Even-lwx/ADS124S08_RTD_Acq/code/code/README.md

# ADS124S08 四路 PT1000 采集与温控库

## 硬件映射

| 功能 | STM32G031 | PCB 网络/器件 | 有效电平 |
| --- | --- | --- | --- |
| SPI SCLK | PA1 | ADS124S08 SCLK | SPI Mode 1 |
| SPI MISO | PA6 | ADS124S08 DOUT/DRDY# | 低表示数据就绪 |
| SPI MOSI | PA7 | ADS124S08 DIN | — |
| SPI CS | PA5 | ADS124S08 CS# | 低有效 |
| Debug TX/RX | PA2/PA3，USART2 | H1-1/H1-2，115200 8N1 | — |
| 业务 TX/RX | PA9/PA10，USART1 | H3 跳线选择 RS485/TTL，9600 8N1 | — |
| RS485 方向 | PC6 | SN65HVD75 DE 与 RE# | 高发送、低接收 |
| PID PWM | PD1，TIM17_CH1 | PCB 的 EN 网络，1 kHz | 高有效 |
| 按键 SW2 | PB3 | BUTTON，R19/R20/SW2 | 按下为低 |
| 黄色 LED1 | PA12 | LED1、R21 | 低电平点亮 |
| 黄色 LED3 | PA15 | LED3、R27 | 低电平点亮 |

H3 短接 1-3、2-4 时 USART1 连接 RS485；短接 3-5、4-6 时连接 H4 TTL。

按键与 LED 极性来自最新原理图
`ADS124S08‑RTD‑Acq-Ver1.0/Sheet1.SchDoc`：BUTTON 节点由 R19（4.7 kΩ）上拉，
按下 SW2 后接地；LED1/LED3 的阳极分别经 1 kΩ 电阻接 3V3，阴极由 MCU 灌电流。

## 自有库目录

- `ads124s08/`：SPI 命令、寄存器配置、ID 校验和单次转换。
- `pt1000/`：比例码值转电阻、通道标定和 IEC 60751 温度换算。
- `pid/`：带积分限幅和输出限幅的离散 PID。
- `app/`：四通道周期采集、串口组帧和仅加热温控。
- `board_io/`：板载 LED 与带 20 ms 非阻塞消抖的按键驱动。
- `rs485/`：USART1 中断收发、PC6 方向切换和帧间隔检测。
- `modbus_rtu/`：支持03读取和06单写的Modbus RTU从机协议层。

## RS485 与 Modbus RTU

USART1 固定配置为 `9600 8N1`，Modbus RTU从机地址固定为 `1`。H3 短接
1-3、2-4 时，PA9/PA10 通过 SN65HVD75 接入 RS485 总线；短接 3-5、4-6
时，同一套Modbus协议以TTL电平从H4输出。PC6同时连接DE和/RE，
发送期间为高电平，最后一个停止位发送完成后立即恢复低电平接收状态。

接收采用USART1单字节中断，连续静默至少4 ms后把完整帧交给协议层。
CRC16初值为 `0xFFFF`、多项式为 `0xA001`，帧内CRC低字节先发送。
支持 `0x03` 读取保持寄存器和 `0x06` 写单个保持寄存器。CRC错误、帧长
错误、其他从机地址以及地址0广播均静默丢弃；非法功能、地址和值分别返回
异常码 `01/02/03`。485写入只保存在RAM，重新上电后恢复固件默认值。

| 地址 | 名称 | 属性 | 编码 |
| --- | --- | --- | --- |
| 0x0000 | 系统状态 | 只读 | bit0使能、bit1加热、bit2反馈有效、bit3过温锁定、bit4 ADC就绪、bit8~11为CH1~CH4有效 |
| 0x0001 | CH1温度 | 只读 | 有符号16位，0.01 ℃；无效为0x8000 |
| 0x0002 | CH2温度 | 只读 | 有符号16位，0.01 ℃；无效为0x8000 |
| 0x0003 | CH3温度 | 只读 | 有符号16位，0.01 ℃；无效为0x8000 |
| 0x0004 | CH4温度 | 只读 | 有符号16位，0.01 ℃；无效为0x8000 |
| 0x0005 | PID最高温度反馈 | 只读 | 有符号16位，0.01 ℃；无效为0x8000 |
| 0x0006 | PWM占空比 | 只读 | 0.01%，例如2400表示24.00% |
| 0x0007 | 目标温度 | 读写 | 0.01 ℃，允许0至严格低于45 ℃ |
| 0x0008 | 加热使能 | 读写 | 0=立即停热，1=下一轮有效采样后恢复 |

写入目标温度或使能状态时，控制器先把PWM归零并清除旧目标的PID历史，
再从下一轮有效温度重新建立平滑参考。过温锁定不能通过485清除，仍然
只能重新上电；全部传感器无效时，485也不能绕过安全停机。

四路ADS124S08采集目前仍是阻塞式操作。USART1中断可以在采样期间完整收帧，
但协议响应要等主循环返回，主机响应超时应设置为至少500 ms。USART2继续
独立输出FireWater数据，不发送任何Modbus内容。Modbus是二进制协议，应使用
Modbus主站软件测试；普通串口文本窗口不会按一行文本显示RTU帧。

## 按键与 LED 接口

`MX_GPIO_Init()` 后调用 `BoardIO_Init()`，并在主循环中持续调用
`BoardButton_Update()`。应用层可使用：

```c
BoardLED_Set(BOARD_LED_1, 1U);       /* 点亮 LED1 */
BoardLED_Toggle(BOARD_LED_3);        /* 翻转 LED3 */

if (BoardButton_GetPressedEvent())   /* 每次稳定按下只返回一次 */
{
  BoardLED_Toggle(BOARD_LED_1);
}
```

`BoardButton_IsPressed()` 返回当前消抖状态；`BoardButton_GetPressedEvent()` 和
`BoardButton_GetReleasedEvent()` 分别读取并清除按下/释放事件。驱动已封装低有效极性。

主循环还会调用 `BoardHeatingIndicator_Update()` 驱动 PA12/LED1：TIM17 实际
占空比大于 0 时，每 100 ms 翻转一次（完整周期 200 ms）；占空比为 0 时，
每 500 ms 翻转一次（完整周期 1 s）。闪烁使用 `HAL_GetTick()` 非阻塞计时，
不会影响温度采集和 PID 更新。

## 独立看门狗

固件在全部外设、采集应用和 PWM 输出初始化完成后启动 IWDG。看门狗使用独立
LSI 时钟、256 分频、重装值 499；按典型 32 kHz LSI 计算，超时时间约为 4 秒。
主循环只有在按键、四路采集、温控和 LED 指示任务全部返回后才喂狗。如果程序
卡死或任务长期不能返回，IWDG 将自动复位 MCU，并由上电安全逻辑先保持加热关闭。

## ADS124S08 配置

| 寄存器 | 值 | 含义 |
| --- | --- | --- |
| PGA (03h) | 08h | PGA 开启，增益 1 |
| DATARATE (04h) | 35h | 单次转换、低延迟滤波、50 SPS |
| REF (05h) | 52h | REFP0/REFN0，内部参考常开供 IDAC，并开启 0.3 V 参考监测 |
| IDACMAG (06h) | 04h | IDAC1/2 幅值 250 µA |
| SYS (09h) | 10h | 无 CRC、无状态前缀 |

通道顺序固定为：

1. IDAC1→AIN11，AIN0-AIN1。
2. IDAC1→AIN10，AIN2-AIN3。
3. IDAC1→AIN9，AIN4-AIN5。
4. IDAC1→AIN8，AIN6-AIN7。

IDAC2 始终断开；SPI 使用 Mode 1、8 MHz。每路单次转换的典型首次结果延迟
约为 26.504 ms，固件保守等待 35 ms；四路每 200 ms 采集一轮，即 5 Hz。

## 标定与串口输出

默认参考电阻为 3000.0 Ω，PT1000 标称电阻为 1000.0 Ω。调用
`PT1000_AppGetDefaultConfig()` 后，可修改参考电阻实测值以及各通道的
`resistance_gain`、`resistance_offset_ohm`。

USART2 在工作模式下每轮输出一行固定 20 列的纯数字 FireWater 数据，
当前输出频率与四路采集和 PID 更新频率一致，均为 5 Hz：

```text
25.01,25.03,24.99,25.02,42.00,25.09,25.03,0.06,0.01,2.000,0.025,4.000,0.12,8.36,0.04,8.52,24.00,0.20,4,1\n
```

列顺序固定为：

```text
T1,T2,T3,T4,SP,REF,FB,ERR,RATE,KP,KI,KD,P,I,D,OUT,LIM,DT,VALID,STATE
```

`SP` 是最终目标温度，`REF` 是从当前反馈平滑接近目标的内部参考温度，
`FB` 是参与控制的合成反馈，`ERR=REF-FB`，`RATE` 是低通滤波后的实际温变速率，
`P/I/D` 是三个实际输出分量，`OUT` 是限幅后的高有效 PWM 占空比，
`LIM` 是当前允许的占空比上限，`DT` 是本次计算间隔，`VALID` 是有效传感器数。
`KP/KI/KD` 固定显示三位小数，其余浮点列显示两位小数，因此 `Ki=0.025`
会原样输出，不再四舍五入显示为 `0.03`。
`STATE=1` 表示正在控制，`STATE=0` 表示传感器不足或控制被禁用，
`STATE=2` 表示任一有效通道达到 45 ℃ 后已锁定停机。状态 0 和 2 均强制
加热输出归零；过温锁定只能通过重新上电清除。失效温度列用 `0.00` 占位，
需结合 `VALID/STATE` 判断。ADC 原始码仍保存在内部快照中，但不输出到
FireWater，避免百万级码值把温度和 PID 曲线压缩在图表底部。

## PWM 与仅加热 PID

TIM17 使用 64 MHz 时钟、PSC=63、ARR=999，在 PD1/EN 输出 1 kHz 高有效 PWM。
每得到一轮新的四通道温度后更新一次 PID，当前反馈为所有有效通道中的最高温度。
至少一路传感器有效时允许控制；全部无效时，占空比立即归零并清除积分项。

PID 参数入口位于 `Core/Src/main.c`：

```c
temperature_control_config.setpoint_c = 42.0f;
temperature_control_config.pid.kp = 2.0f;
temperature_control_config.pid.ki = 0.025f;
temperature_control_config.pid.kd = 4.0f;
temperature_control_config.pid.derivative_filter_time_constant_s = 1.0f;
temperature_control_config.reference_time_constant_s = 12.0f;
temperature_control_config.reference_max_rate_c_per_s = 0.30f;
temperature_control_config.pid.integral_max = 12.0f;
temperature_control_config.feedback_mode = TEMPERATURE_FEEDBACK_MAXIMUM;
temperature_control_config.overtemperature_c = 45.0f;
```

控制器使用两自由度结构。内部参考 `REF` 从首次有效反馈开始，以 12 s 一阶时间常数
和最大 0.30 ℃/s 速度接近 42 ℃，因此初始温差不会直接产生很大的比例输出。
`Kp=2.0`、`Kd=4.0` 对参考跟踪误差和变化率进行修正，D 项使用 1 s 一阶低通，
避免 ADC 噪声被放大。积分项以电压曲线给出的维持功率作为前馈初值；只有最终
目标误差不超过 2 ℃且实际温变速率不超过 0.10 ℃/s 时，`Ki=0.025` 才在线
学习当前散热环境所需的维持功率。积分仍带 0～12% 限幅和条件抗饱和。
安全限幅只限制占空比；TPS27S100 导通时的输出高电平仍接近 VIN。
本板未把 VIN 接入 MCU ADC，因此固件无法在 12～24 V 变化时自动换算功率限幅。

控制误差为“内部参考温度 - 反馈温度”，最终目标始终保持 42 ℃。输出下限为 0%，所以框架只会
加热，不会产生制冷方向。PD1/EN 的 PWM 为高电平有效。反馈可选
平均值、最大值、最小值或指定通道，见 `TemperatureControl_FeedbackMode`。

### PWM 阶梯测试模式

`Core/Src/main.c` 中的 `PWM_RUN_MODE` 是唯一的模式选择宏。当前值为
`PWM_RUN_MODE_WORK`，固件使用四路温度反馈进行 PID 控制。需要验证硬件时，
可将该宏改为 `PWM_RUN_MODE_TEST`；固件将绕过 PID，让 PD1/EN 按
10 秒间隔循环输出 20%、40%、60%、80% 和 90% 高电平占空比。PWM 硬件
测试模式不执行 PID，因此不输出上述 FireWater 温控帧。

### 输入电压补偿

`Core/Src/main.c` 中的 `TEMPERATURE_INPUT_VOLTAGE_V` 是实际接入 VIN 的电压宏，
当前默认值为 `12.0f`。初始化温控器时，`temperature_control_profile.c` 会依据实测
日志只对维持功率前馈初值和安全输出上限进行分段线性插值：

| VIN | 9 V | 12 V | 15 V | 18 V | 24 V |
| --- | ---: | ---: | ---: | ---: | ---: |
| 积分初值前馈（%） | 10.78 | 8.36 | 7.43 | 7.27 | 7.10 |
| PWM 输出上限（%） | 30.0 | 24.0 | 24.0 | 24.0 | 18.0 |

9~18 V 的锚点来自 680 ohm 限流电阻下四份实测数据尾段的 `I` 积分项平均值，24 V 为设计上限
处的保守外推值。Kp、Ki、Kd、参考轨迹和速率滤波不按电压或绝对温度查表，
避免把某次环境下的升温曲线固化进控制器。电压表中的积分初值只是上电先验值，
实际维持功率由闭环在目标附近在线学习。学习值保存在 RAM，重新上电后从电压表
初值重新开始，避免频繁写 Flash。
改变电压时只需修改该宏并重新编译；函数会把超出 9~24 V 的值限制到最近端点。

## 硬件限制

最新版 `Sheet1.SchDoc` 中，ADS124S08 的 START/SYNC 通过 AGND 电源端口接地，
RESET# 通过 3V3 电源端口拉高，满足数据手册的软件命令控制要求。独立 DRDY#
未连接，固件按数据手册第 71 页使用 SPI MISO 上复用的 DOUT/DRDY 状态轮询。
