Even-lwx/ADS124S08_RTD_Acq/(list of files, drawings)

Other design files:
pcb/ADS124S08‑RTD‑Acq/ADS124S08‑RTD‑Acq-Ver1.0/ADS124S08‑RTD‑Acq.PrjPcb
pcb/ADS124S08‑RTD‑Acq/ADS124S08‑RTD‑Acq-Ver1.0/PCB1.PcbDoc
pcb/ADS124S08‑RTD‑Acq/ADS124S08‑RTD‑Acq-Ver1.0/Sheet1.SchDoc
pcb/ADS124S08‑RTD‑Acq/ADS124S08‑RTD‑Acq/PCB1.PcbDoc
pcb/ADS124S08‑RTD‑Acq/ADS124S08‑RTD‑Acq/Sheet1.SchDoc
