Even-lwx/ADS124S08_RTD_Acq/code/Core/Src/main.c

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
/* Includes ------------------------------------------------------------------*/
#include "main.h"
#include "spi.h"
#include "tim.h"
#include "usart.h"
#include "gpio.h"
#include "iwdg.h"

/* USER CODE BEGIN Includes */

#include "pt1000_app.h"
#include "temperature_control.h"
#include "temperature_control_profile.h"
#include "pwm_duty_test.h"
#include "board_io.h"
#include "temperature_modbus.h"

/* USER CODE END Includes */

/* USER CODE BEGIN PTD */

/** @brief PWM 输出运行模式。 */
typedef enum
{
  PWM_RUN_MODE_WORK = 0, /**< 正常工作：由四路温度反馈和 PID 调整占空比。 */
  PWM_RUN_MODE_TEST      /**< 测试模式：循环输出五档固定占空比。 */
} PWM_RunMode;

/* USER CODE END PTD */

/* USER CODE BEGIN PD */

/** 只需修改此宏即可在正常 PID 工作模式和 PWM 阶梯测试模式之间切换。 */
#define PWM_RUN_MODE PWM_RUN_MODE_WORK

/*
 * 第二轮整定加入小积分项。Kp 的单位为“占空比百分点/℃”：
 * 例如跟踪误差为 1 ℃、Kp=2 时，P 输出为 2%。
 * Ki 的单位为“占空比百分点/(℃·s)”，用于缓慢消除纯 P 稳态误差。
 */
#define TEMPERATURE_SETPOINT_C 42.0f
#define TEMPERATURE_INPUT_VOLTAGE_V 14.0f
#define TEMPERATURE_PID_KP      2.0f
#define TEMPERATURE_PID_KI      0.025f
#define TEMPERATURE_PID_KD      4.0f
/** 内部参考轨迹的一阶时间常数；越大则接近目标时减速越早。 */
#define TEMPERATURE_REFERENCE_TIME_CONSTANT_S 12.0f
/** 内部参考轨迹允许的最大升温/降温速度。 */
#define TEMPERATURE_REFERENCE_MAX_RATE_C_PER_S 0.30f
/** D 项低通滤波时间常数，用于抑制 ADC 噪声放大。 */
#define TEMPERATURE_D_FILTER_TIME_CONSTANT_S 1.0f
/** 工作模式下允许输出的最大高有效 PWM 占空比。 */
#define TEMPERATURE_PWM_MAX_DUTY_PERCENT 30.0f
/** 积分项单独限幅，避免积分独自给出过大的持续加热功率。 */
#define TEMPERATURE_PID_INTEGRAL_MAX_PERCENT 12.0f
/** 默认值；实际值由 TEMPERATURE_INPUT_VOLTAGE_V 的电压曲线函数覆盖。 */
#define TEMPERATURE_PID_INTEGRAL_INITIAL_PERCENT 5.5f
/** 任一有效通道到达此温度时锁定关闭加热，直到重新上电。 */
#define TEMPERATURE_OVERTEMPERATURE_C 45.0f
/** 非 0 时每轮输出一行纯数字 FireWater 温控数据，当前采集频率为 5 Hz。 */
#define TEMPERATURE_PID_TELEMETRY_ENABLE 1U
/** USART1/RS485 上固定使用的 Modbus RTU 从机地址。 */
#define TEMPERATURE_MODBUS_SLAVE_ADDRESS 1U

/* USER CODE END PD */


/* USER CODE BEGIN PV */

static PT1000_App pt1000_app;
static PT1000_AppConfig pt1000_config;
static PWM_DutyTest pwm_duty_test;
static TemperatureControl temperature_control;
static TemperatureControl_Config temperature_control_config;
static TemperatureModbus_HandleTypeDef temperature_modbus;

/* USER CODE END PV */

void SystemClock_Config(void);
/**
  * @brief  The application entry point.
  * @retval int
  */
int main(void)
{
  /* MCU Configuration--------------------------------------------------------*/

  /* Reset of all peripherals, Initializes the Flash interface and the Systick. */
  HAL_Init();

  /* Configure the system clock */
  SystemClock_Config();

  /* Initialize all configured peripherals */
  MX_GPIO_Init();
  /* USART2/H1 用于输出纯数字 FireWater 温控数据。 */
  MX_USART2_UART_Init();
  MX_SPI1_Init();
  MX_TIM17_Init();
  MX_USART1_UART_Init();
  /* USER CODE BEGIN 2 */

  BoardIO_Init();

  PT1000_AppGetDefaultConfig(&pt1000_config);
  PT1000_AppInit(&pt1000_app, &hspi1, &huart2,
                 ADS124S08_CS_GPIO_Port, ADS124S08_CS_Pin,
                 GPIOA, GPIO_PIN_6, &pt1000_config);

  if (PWM_RUN_MODE == PWM_RUN_MODE_TEST)
  {
    /* 测试模式绕过 PID，避免温度有效性检查把测试占空比重新置为 0%。 */
    if (PWM_DutyTest_Init(&pwm_duty_test, &htim17,
                          TIM_CHANNEL_1) != HAL_OK)
    {
      __HAL_TIM_SET_COMPARE(&htim17, TIM_CHANNEL_1, 0U);
    }
  }
  else
  {
    TemperatureControl_GetDefaultConfig(&temperature_control_config);
    /* 根据首轮纯 P 曲线加入小积分项，用于消除约 2.37 ℃ 稳态误差。 */
    temperature_control_config.setpoint_c = TEMPERATURE_SETPOINT_C;
    temperature_control_config.pid.kp = TEMPERATURE_PID_KP;
    temperature_control_config.pid.ki = TEMPERATURE_PID_KI;
    temperature_control_config.pid.kd = TEMPERATURE_PID_KD;
    temperature_control_config.pid.derivative_filter_time_constant_s =
        TEMPERATURE_D_FILTER_TIME_CONSTANT_S;
    temperature_control_config.pid.output_max =
        TEMPERATURE_PWM_MAX_DUTY_PERCENT;
    temperature_control_config.pid.integral_max =
        TEMPERATURE_PID_INTEGRAL_MAX_PERCENT;
    temperature_control_config.pid.integral_initial =
        TEMPERATURE_PID_INTEGRAL_INITIAL_PERCENT;
    /* 根据实际 VIN 只选择维持功率前馈初值和硬件安全输出上限。 */
    TemperatureControl_ApplyVoltageProfile(&temperature_control_config,
                                           TEMPERATURE_INPUT_VOLTAGE_V);
    temperature_control_config.reference_time_constant_s =
        TEMPERATURE_REFERENCE_TIME_CONSTANT_S;
    temperature_control_config.reference_max_rate_c_per_s =
        TEMPERATURE_REFERENCE_MAX_RATE_C_PER_S;
    temperature_control_config.feedback_mode =
        TEMPERATURE_FEEDBACK_MAXIMUM;
    temperature_control_config.overtemperature_c =
        TEMPERATURE_OVERTEMPERATURE_C;
    temperature_control_config.telemetry_enabled =
        TEMPERATURE_PID_TELEMETRY_ENABLE;
    if (TemperatureControl_Init(&temperature_control, &htim17, TIM_CHANNEL_1,
                                &pt1000_app,
                                &temperature_control_config) != HAL_OK)
    {
      /* PWM/PID 初始化失败时保持 PD1/EN 为安全的非加热状态。 */
      __HAL_TIM_SET_COMPARE(&htim17, TIM_CHANNEL_1, 0U);
    }
    else
    {
      /*
       * USART1 固定为 9600 8N1，PC6 高发送、低接收。初始化失败不会
       * 影响本地采集和温控，只会令 485 业务保持不可用。
       */
      (void)TemperatureModbus_Init(&temperature_modbus, &huart1,
                                   RS485_DE_RE_GPIO_Port,
                                   RS485_DE_RE_Pin,
                                   TEMPERATURE_MODBUS_SLAVE_ADDRESS,
                                   &pt1000_app, &temperature_control);
    }
  }
  /* 定时器输出启动后再把 PD1 切为复用功能，避免 EN 出现启动毛刺。 */
  MX_TIM17_PWM_GPIO_Init();

  /* 所有应用和加热输出均进入确定状态后再启动约 4 秒独立看门狗。 */
  MX_IWDG_Init();

  /* USER CODE END 2 */

  /* Infinite loop */
  /* USER CODE BEGIN WHILE */
  while (1)
  {
    BoardButton_Update();
    /* 在进入阻塞式 ADC 采样前先处理已经收完的 Modbus RTU 请求。 */
    TemperatureModbus_Process(&temperature_modbus, HAL_GetTick());
    PT1000_AppTask(&pt1000_app);
    if (PWM_RUN_MODE == PWM_RUN_MODE_TEST)
    {
      PWM_DutyTest_Task(&pwm_duty_test);
    }
    else
    {
      TemperatureControl_Task(&temperature_control);
    }

    /* ADC 采样期间收到的帧在这里尽快应答，最坏延迟约为一轮采样时间。 */
    TemperatureModbus_Process(&temperature_modbus, HAL_GetTick());

    /* 直接读取 TIM17 实际比较值，兼容 PID 工作模式和 PWM 阶梯测试模式。 */
    BoardHeatingIndicator_Update(
        (__HAL_TIM_GET_COMPARE(&htim17, TIM_CHANNEL_1) != 0U) ? 1U : 0U);

    /* 只有本轮按键、采集、温控和状态指示任务全部返回后才刷新看门狗。 */
    if (HAL_IWDG_Refresh(&hiwdg) != HAL_OK)
    {
      Error_Handler();
    }
    /* USER CODE END WHILE */

    /* USER CODE BEGIN 3 */
  }
  /* USER CODE END 3 */
}

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
/* USER CODE BEGIN 4 */

/** @brief USART1 最后一个停止位发送完成后恢复 RS485 接收方向。 */
void HAL_UART_TxCpltCallback(UART_HandleTypeDef *huart)
{
  TemperatureModbus_OnUartTxCompleteISR(&temperature_modbus, huart);
}

/** @brief 把 USART1 收到的单个字节交给 RS485 帧缓冲区。 */
void HAL_UART_RxCpltCallback(UART_HandleTypeDef *huart)
{
  TemperatureModbus_OnUartRxCompleteISR(&temperature_modbus, huart);
}

/** @brief 发生溢出、帧错误或噪声错误时丢弃当前帧并恢复接收。 */
void HAL_UART_ErrorCallback(UART_HandleTypeDef *huart)
{
  TemperatureModbus_OnUartErrorISR(&temperature_modbus, huart);
}

/* USER CODE END 4 */
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
