Even-lwx/ADS124S08_RTD_Acq/code/code.ioc

Mcu.UserName=STM32G031C8Tx
PA1.Signal=SPI1_SCK
PA10.Signal=USART1_RX
PA13.Signal=SYS_SWDIO
PA14-BOOT0.Signal=SYS_SWCLK
PA15.GPIO_Label=LED3
PA15.Signal=GPIO_Output
PA2.Signal=USART2_TX
PA3.Signal=USART2_RX
PA5.GPIO_Label=ADS124S08_CS
PA5.Signal=GPIO_Output
PA6.Signal=SPI1_MISO
PA7.Signal=SPI1_MOSI
PA9.Signal=USART1_TX
PB3.GPIO_Label=BUTTON
PB3.Signal=GPIO_Input
PC6.GPIO_Label=RS485_DE_RE
PC6.Signal=GPIO_Output
PD1.GPIO_Label=BOARD_EN
PD1.Signal=TIM17_CH1
