Even-lwx/ADS124S08_RTD_Acq/(commit log)

2026-09-16 feat: 完成四路PT1000采集与加热控制
    - 实现ADS124S08四通道轮询采集、寄存器校验和异常处理
    - 增加PT1000温度换算、标定参数及USART2固定格式输出
    - 配置USART1作为RS485/TTL预留业务串口
    - 增加仅加热PID框架，使用PD1/TIM17输出高有效1kHz PWM
    - 增加板载按键消抖及LED控制驱动
    - 同步CubeMX与Keil工程配置，并为自写库补充中文注释
2026-09-18 feat: 完善ADS124S08采集诊断与板级温控
    实现四路PT1000顺序采集、比例参考换算和USART2数据输出。
    补充ADS124S08寄存器校验、参考回路/模拟电源/IDAC诊断及开路状态输出。
    加入PD1高有效PWM、仅加热PID框架、按键LED驱动和双串口配置。
2026-09-18 refactor: 移除采集诊断并整理正式输出
    删除 ADS124S08 参考回路、模拟电源和 IDAC 临时自检，以及 USART2 启动和故障日志。
    USART2 仅保留固定八字段温度数据帧，同时保留采样故障判定、自动重试和加热安全关闭逻辑。
    整理采集应用状态、硬件拓扑说明和中文注释。
2026-09-18 feat: 完善PD1 PWM模式切换与硬件测试
2026-09-18 feat: 完善5Hz温度闭环与安全保护
    - 将ADS124S08调整为50 SPS并以5 Hz完成四路采集和PID更新
    - 输出固定18列FireWater温控数据并保留PID参数精度
    - 使用最高有效温度反馈和双传感器冗余，加入30% PWM限幅及48度过温锁定
    - 增加PI条件积分抗饱和、积分限幅和12 V工况积分预置
    - 整理PWM测试模式、中文注释和使用说明
2026-09-18 feat: 增加LED1加热指示与独立看门狗
2026-09-18 log提交
    [2609181414_PID调参数据.csv, 2609181450_PID调参数据_1.5K限流.csv, 2609181453_PID调参数据_1.5K限流.csv, 2609181510_PID调参数据_680欧限流.csv, 2609181516_PID调参数据_680欧限流.csv, 2609181528_PID调参数据_680欧限流.csv, 2609181546_PID调参数据_680欧限流.csv, 2609181602_PID调参数据_680欧限流.csv]
2026-09-20 feat: 完善多电压自适应温控策略及测试数据
2026-09-20 feat: 实现RS485 Modbus RTU温控通信
2026-09-20 长时间log
2026-10-09 改成只有一个温度传感器就可以开启恒温
2026-11-05 将项目说明和注释统一为中文
2026-11-05 完善中文工程文档和注释
2026-11-05 补充项目根目录中文说明
2026-11-06 补齐温控采集板硬件源文件并完善目录说明
2026-11-06 收录qModMaster调试工具并补充中文通信说明
